eleccoder/raspi-pico-aprs-tnc/doc/img/rpi_pico.jpg

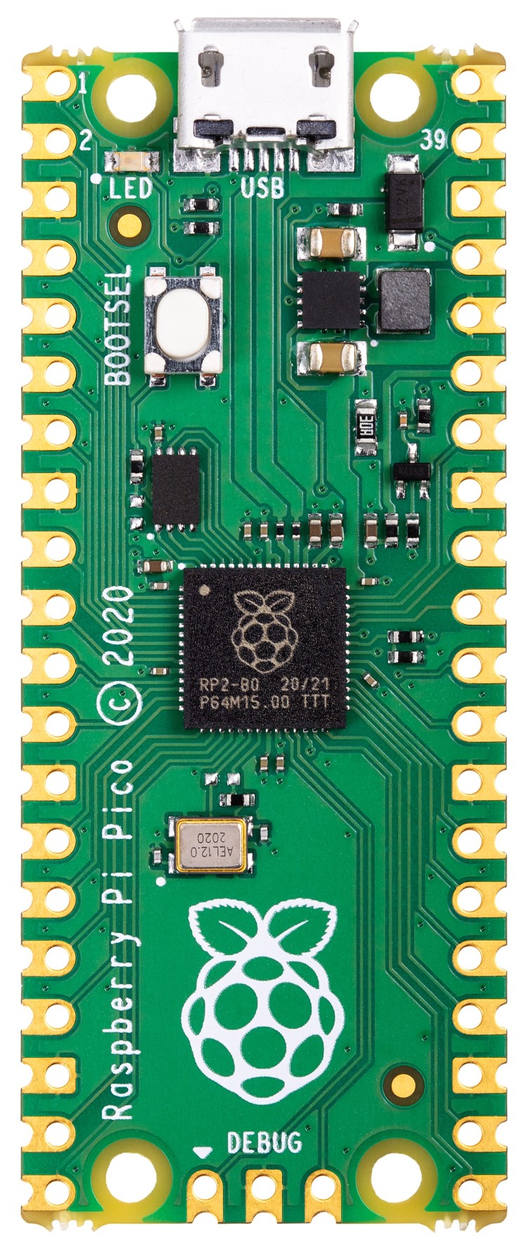
doc/img/rpi_pico.jpg
