eleccoder/raspi-pico-aprs-tnc/doc/schematic_EAGLE/APRS_Pico_with_Baofeng_UV-5R.pdf

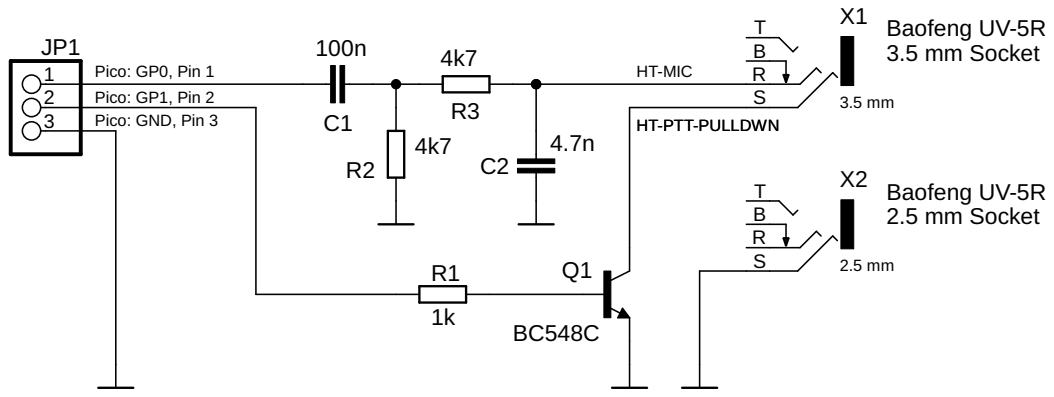
[picture p6: page 1]

Document Number: | REV: 1.0

Date: 28.12.2022 19:40 | Sheet: 1/1
