eleccoder/raspi-pico-aprs-tnc/doc/simulation_LTSpice/Bandpass_AFSK_1200.asc

C1: cap; 4.7n
C2: cap; 100n
R1: res; 4.7k
R2: res; 4.7k
R3: res; 10k
V1: voltage; SINE(); AC 1
Named nets: 0, out
.ac dec 1000 1 100000
Load
