eleccoder/raspi-pico-aprs-tnc/doc/schematic_EAGLE/APRS_Pico_with_Baofeng_UV-5R.sch

## EAGLE design doc/schematic_EAGLE/APRS_Pico_with_Baofeng_UV-5R.sch (2022-12-28)

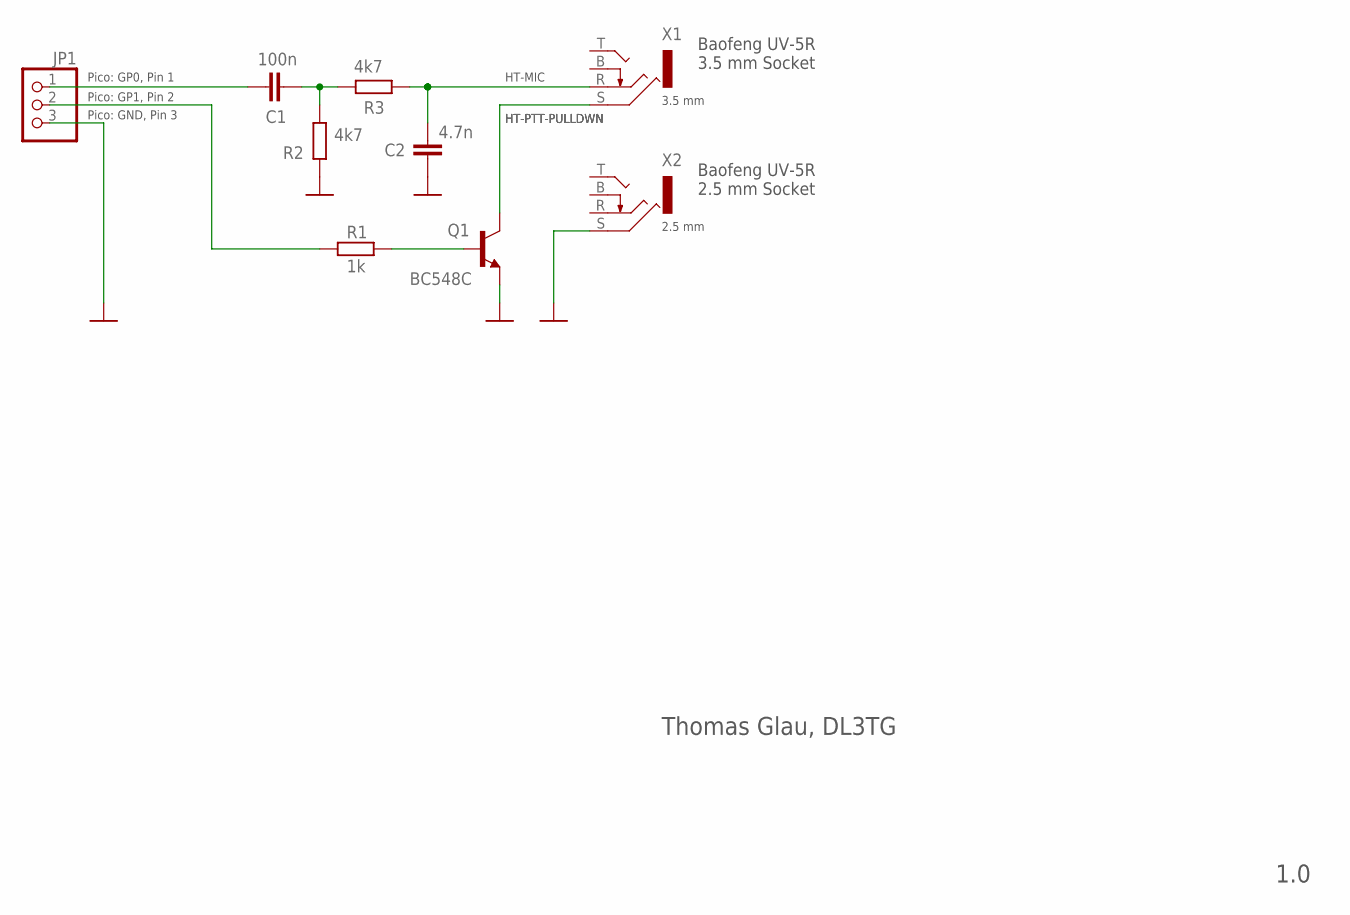
[picture p7: schematic APRS_Pico_with_Baofeng_UV-5R.sch]

Parts:
C1: 100n; C0805
C2: 4.7n; C0805
JP1: PINHD-1X3; 1X03
Q1: BC548C; TO92-EBC
R1: 1k; 0207/10
R2, R3: 4k7; R0805
X1, X2: KLBR4

Connections:
GND: C2.1, JP1.3, Q1.E, R2.1, X2.S
GP0: C1.1, JP1.1
HT-PTT-PULLDWN: Q1.C, X1.S
LINE-OUT: C2.2, R3.1, X1.R
unnamed: JP1.2, R1.1
unnamed: C1.2, R2.2, R3.2
unnamed: Q1.B, R1.2

Notes on the sheet:
Thomas Glau, DL3TG
1.0
3.5 mm
2.5 mm
Baofeng UV-5R 3.5 mm Socket
Baofeng UV-5R 2.5 mm Socket
Pico: GP0, Pin 1
Pico: GP1, Pin 2
Pico: GND, Pin 3
HT-MIC
