eleccoder/raspi-pico-aprs-tnc/doc/schematic_EAGLE/band_pass_filter.sch

## EAGLE design doc/schematic_EAGLE/band_pass_filter.sch (2021-08-02)

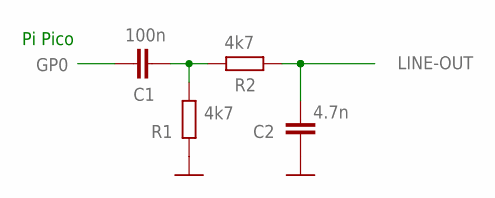
[picture p8: schematic band_pass_filter.sch]

Parts:
C1: 100n; C0805
C2: 4.7n; C0805
R1, R2: 4k7; R0805

Connections:
GND: C2.1, R1.1
GP0: C1.1
LINE-OUT: C2.2, R2.1
unnamed: C1.2, R1.2, R2.2

Notes on the sheet:
Pi Pico
