eleccoder/raspi-pico-aprs-tnc/(threads)

Thread 1 (2024-03-31):

Failed assertion when running demo apps

aschuhardt, 2024-03-31:
Are you able to run the demo apps with the current pico-extras revision?  I'm running into this failed assertion exception when calling the `sendAPRS` method.

The assertion in question can be found [here](https://github.com/raspberrypi/pico-extras/blob/09c64d509f1d7a49ceabde699ed6c74c77e195a1/src/common/pico_audio/include/pico/sample_conversion.h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).

```
__breakpoint@0x10006c28 (c:\Program Files\...\pico-sdk\src\rp2_common\pico_platform\include\pico\platform.h:345)
_exit@0x10006ddc (c:\Program Files\...\pico-sdk\src\rp2_common\pico_runtime\runtime.c:187)
__assert_func@0x10006e88 (c:\Program Files\...\pico-sdk\src\rp2_common\pico_runtime\runtime.c:271)
producer_pool_blocking_give<FmtPWM, FmtS16>@0x100016b2 (c:\Program Files\...\pico-extras\src\common\pico_audio\include\pico\sample_conversion.h:261)
producer_pool_blocking_give_to_pwm_s16@0x10001610 (c:\Program Files\...\pico-extras\src\rp2_common\pico_audio_pwm\sample_encoding.cpp:411)
give_audio_buffer@0x10005fb8 (c:\Program Files\...\pico-extras\src\common\pico_audio\audio.cpp:216)
aprs_pico_renderAudioSamples@0x1000b29c (raspi-pico-aprs-tnc\src\aprs_pico.c:163)
aprs_pico_sendAPRSAudioCallback@0x1000b32e (raspi-pico-aprs-tnc\src\aprs_pico.c:183)
ax25_frame@0x1000bd34 (Unknown Source:0)
ax25_beacon@0x1000b568 (Unknown Source:0)
aprs_pico_sendAPRS@0x1000b42e (raspi-pico-aprs-tnc\src\aprs_pico.c:256)
main@0x10000356 (raspi-pico-aprs-tnc\src\aprs_pico_beacon_demo.c:64)
```

eleccoder, 2024-05-30:
Hello @aschuhardt, I'm very sorry for not replying sooner. I don't remember to have gotten an email notification ... Anyway, I just tried to build and run the demo program based on the today's master branches of the pico-sdk and pico-extras: The demo was running fine, w/o any exception. So, pls. tell whether your issue still exists or not. Thanks, Thomas

eleccoder, 2024-09-08:
Closed since no response from the reporter.

Thread 3 (2025-04-08):

Dangling reference in aprs_pico_init()

ArkinSolomon, 2025-04-08:
A dangling reference is retained to the configuration structs [here](https://github.com/ArkinSolomon/raspi-pico-aprs-tnc/blob/57ce0dc184275537588403ac901b10d6e02f3f25/src/aprs_pico.c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). This is related to #1, and causes an assertion if the memory is reused. Moving the variables out of the stack fixes this issue. `pico_audio` stores these configuration structs by reference and not by value.

eleccoder, 2025-04-08:
Hi Arkin, oh yes, that's definitively an issue, it needs to be fixed.

eleccoder, 2025-07-23:
Fixed by commit 097b411ae96362072d6ca8354de15d1606d3728e

Closed 2025-07-23.
