eleccoder/raspi-pico-aprs-tnc/include/aprs_pico.h

/*
* Project 'raspi-pico-aprs-tnc'
* Copyright (C) 2021-2023 Thomas Glau, DL3TG
*
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
* You should have received a copy of the GNU General Public License
* along with this program. If not, see <http://www.gnu.org/licenses/>.
*/

#pragma once

#ifdef __cplusplus
extern "C" {
#endif

#include <stdint.h>
#include <stdbool.h>

#include "pico/audio_pwm.h" // For 'audio_buffer_pool_t'


/** \brief Initializes the APRS Pico library
 *
 * \return A pool of audio buffers to be used for rendering any audio signal
 */
audio_buffer_pool_t* aprs_pico_init();


/** \brief Generates the AFSK PWM-signal for a given APRS message at GPIO-pin 'GP0'
 *
 * \param[in, out] audio_buffer_pool  The pool of audio buffers to be used for rendering the APRS audio signal
 * \param[in]      call_sign_src      The source      call sign
 * \param[in]      call_sign_dst      The destination call sign
 * \param[in]      aprs_path_1        The first  APRS path
 * \param[in]      aprs_path_2        The second APRS path
 * \param[in]      aprs_message       The APRS message text (may be 'NULL' pointer)
 * \param[in]      latitude_in_deg    The latitude  of the geo-location (in degrees)
 * \param[in]      longitude_in_deg   The longitude of the geo-location (in degrees)
 * \param[in]      altitude_in_m      The altitude  of the geo-location (in meters)
 * \param[in]      sym_table          The APRS symbol table (e.g. '/' stands for 'Primary')
 * \param[in]      sym_code           The APRS symbol code  (e.g. '-' stands for 'House QTH')
 * \param[in]      volume             The volume level of the generated signal (0 ... 256)
 *
 * \retval         'true'  - Successful operation
 * \retval         'false' - An error occurred
 *
 */
bool aprs_pico_sendAPRS(audio_buffer_pool_t* audio_buffer_pool,
                        const char*          call_sign_src,
                        const char*          call_sign_dst,
                        const char*          aprs_path_1,
                        const char*          aprs_path_2,
                        const char*          aprs_message,
                        double               latitude_in_deg,
                        double               longitude_in_deg,
                        double               altitude_in_m,
                        char                 sym_table,
                        char                 sym_code,
                        uint16_t             volume);


/** \brief Generates a sine wave PWM-signal at GPIO-pin 'GP0'
 *
 * \param[in, out] audio_buffer_pool  The pool of audio buffers to be used for rendering the sine audio signal
 * \param[in]      freq_in_hz         The frequency of the sine wave to be generated (in Hz)
 * \param[in]      sample_freq_in_hz  The sampling frequency of the sine wave to be generated (in Hz)
 * \param[in]      volume             The volume level of the generated signal (0 ... 256)
 * \param[in]      duration_in_ms     For 'duration_in_ms' >= 0: Duration of the sine wave playing (in ms)
 *                                    For 'duration_in_ms'  < 0: Plays the sine wave endlessly
 */
void aprs_pico_play_sine_wave(audio_buffer_pool_t* audio_buffer_pool, unsigned int freq_in_hz,
                              unsigned int sample_freq_in_hz, uint16_t volume, int duration_in_ms);

#ifdef __cplusplus
}
#endif
