eleccoder/raspi-pico-aprs-tnc/(commit log)

2021-08-02 Revised band-pass-filter
    [band_pass_filter.sch]
2021-11-13 Minor corrections in the doxydoc
    [aprs_pico.h]
2022-11-18 git submodule init required for pico-extras
2022-12-21 Improved program flow
2022-12-28 APRS symbol table/code no longer fixed
    [aprs_pico.c, aprs_pico.h, aprs_pico_beacon_demo.c]
2022-12-28 Update to current 'beacon' demo output
2024-09-12 Compile with pico-sdk 2.0.0
